zimward/datalogger/README.md

4-20mA dual channel Datalogger for long term averaging of in-field bus systems
