zimward/datalogger/hardware/Datenlogger.kicad_pcb

## KiCad design hardware/Datenlogger.kicad_pcb (2026-04-29)

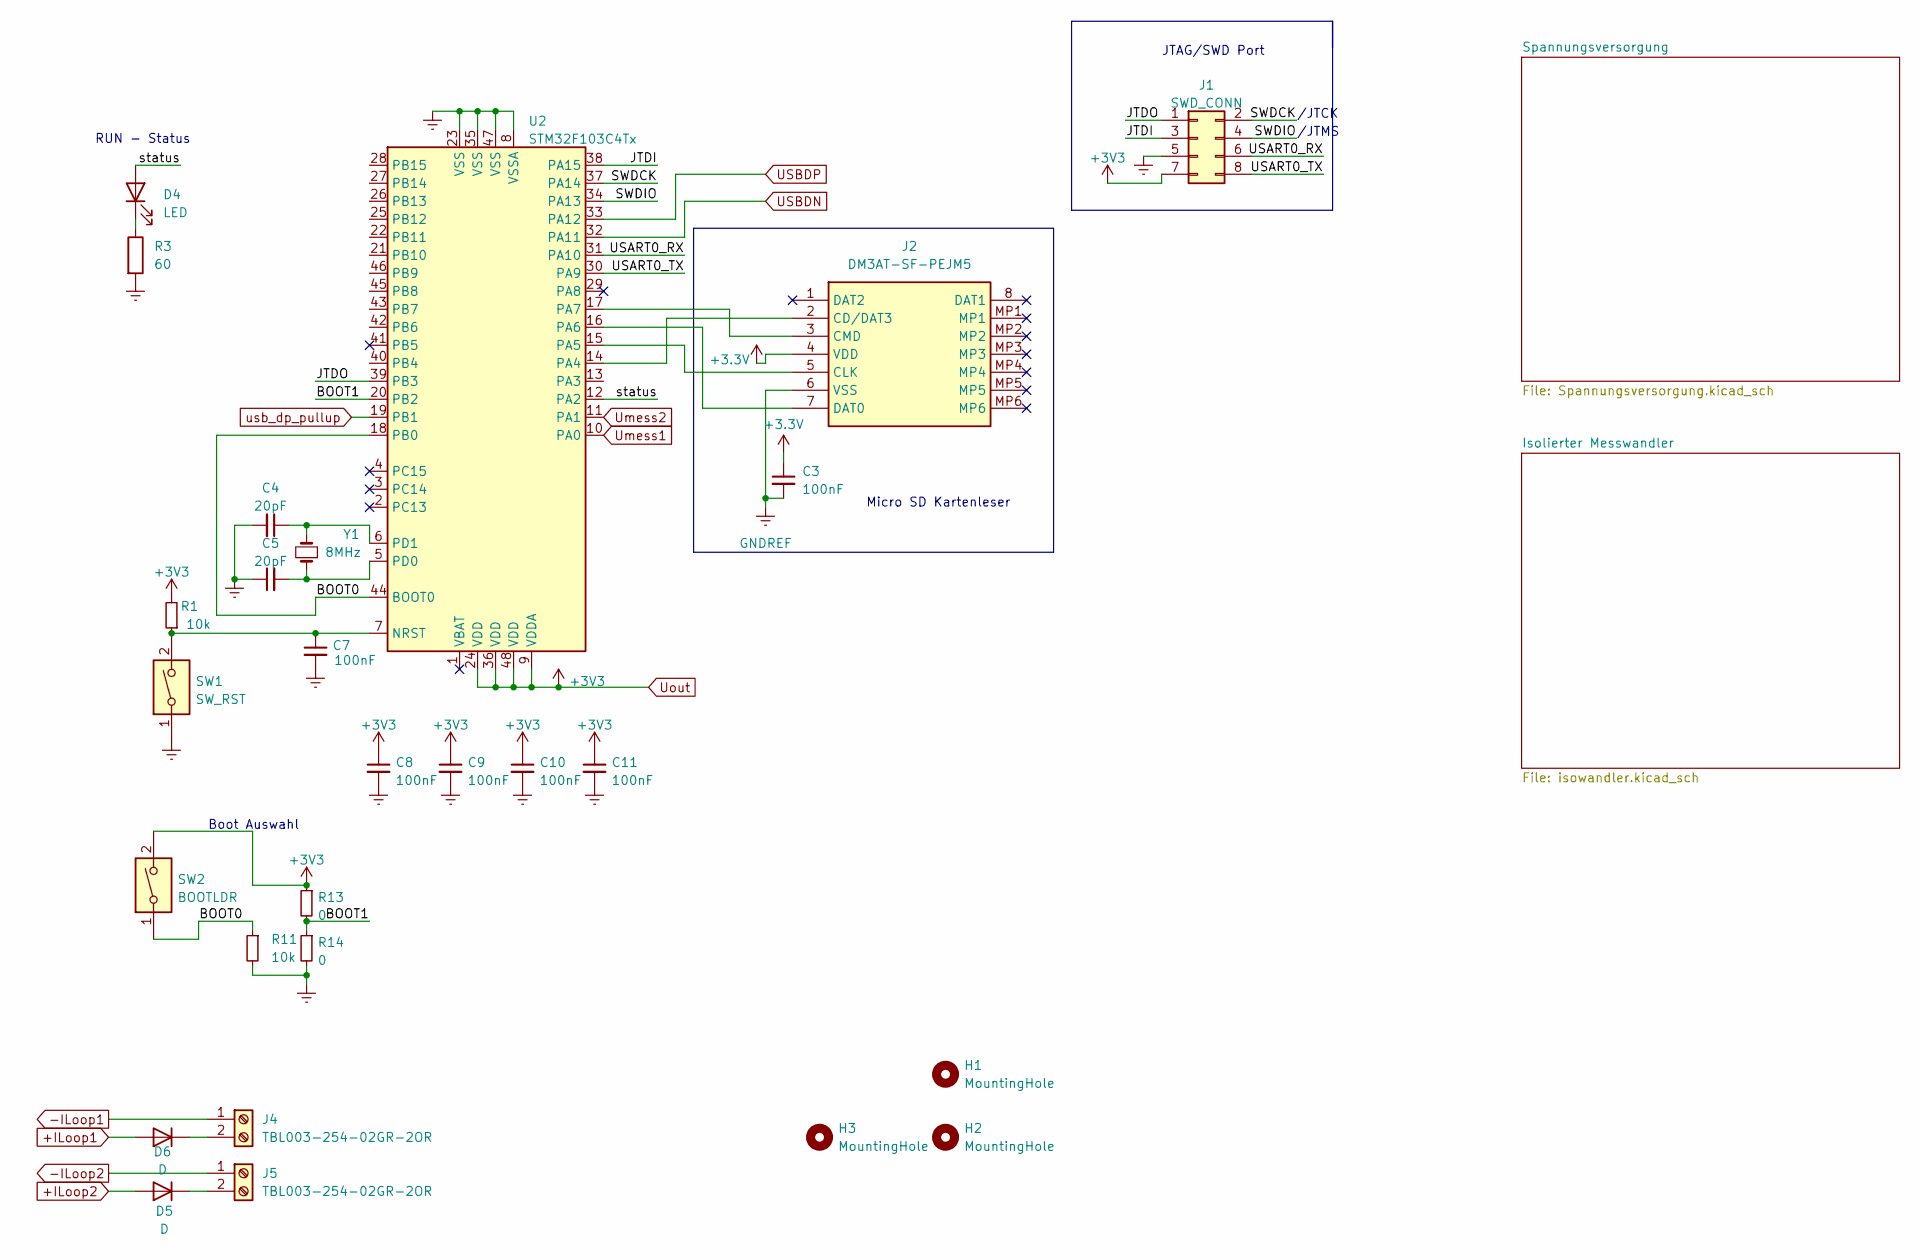
[picture p1: schematic Datenlogger.kicad_sch]

Parts:
C3, C7, C8, C9, C10, C11: 100nF; C_0805_2012Metric_Pad1.18x1.45mm_HandSolder
C4, C5: 20pF; C_0805_2012Metric_Pad1.18x1.45mm_HandSolder
D4: LED; LED_0805_2012Metric_Pad1.15x1.40mm_HandSolder
D5, D6: D; D_SOD-123
H1, H2, H3: MountingHole; MountingHole_3.2mm_M3_DIN965
J1: SWD_CONN; PinHeader_2x04_P2.54mm_Vertical
J2: DM3AT-SF-PEJM5; DM3ATSFPEJM5; Mouser Part Number 798-DM3AT-SF-PEJM5
J4, J5: TBL003-254-02GR-2OR; SHDR4W70P508X254_2X2_768X1380X1275P
R1, R11: 10k; R_0805_2012Metric_Pad1.20x1.40mm_HandSolder
R3: 60; R_0805_2012Metric_Pad1.20x1.40mm_HandSolder
R13, R14: 0; R_0805_2012Metric_Pad1.20x1.40mm_HandSolder
SW1: SW_RST; SW_DIP_SPSTx01_Slide_6.7x4.1mm_W7.62mm_P2.54mm_LowProfile
SW2: BOOTLDR; SW_DIP_SPSTx01_Slide_6.7x4.1mm_W7.62mm_P2.54mm_LowProfile
U2: STM32F103C4Tx; LQFP-48_7x7mm_P0.5mm
Y1: 8MHz; Crystal_SMD_HC49-SD

Connections:
+ILoop1: D6.2 (A); also elsewhere on the board
+ILoop2: D5.2 (A); also elsewhere on the board
-ILoop1: J4.1; also elsewhere on the board
-ILoop2: J5.1; also elsewhere on the board
/BOOT0: R11.1, SW2.1, U2.18 (PB0), U2.44 (BOOT0)
/BOOT1: R13.2, R14.1, U2.20 (PB2)
/JTDI: J1.3, U2.38 (PA15)
/JTDO: J1.1, U2.39 (PB3)
/SWDCK: J1.2, U2.37 (PA14)
/SWDIO: J1.4, U2.34 (PA13)
/USART0_RX: J1.6, U2.31 (PA10)
/USART0_TX: J1.8, U2.30 (PA9)
/status: D4.2 (A), U2.12 (PA2)
GNDREF: C3.2, C4.2, C5.1, C7.2, C8.2, C9.2, C10.2, C11.2, J1.5, J2.6 (VSS), R3.2, R11.2, R14.2, SW1.1, U2.8 (VSSA), U2.23 (VSS), U2.35 (VSS), U2.47 (VSS); also elsewhere on the board
unnamed: D4.1 (K), R3.1
unnamed: D5.1 (K), J5.2
unnamed: D6.1 (K), J4.2
unnamed: J2.2 (CD/DAT3), U2.14 (PA4)
unnamed: J2.5 (CLK), U2.15 (PA5)
unnamed: J2.3 (CMD), U2.17 (PA7)
unnamed: J2.7 (DAT0), U2.16 (PA6)
unnamed: C7.1, R1.1, SW1.2, U2.7 (NRST)
unnamed: C5.2, U2.5 (PD0), Y1.1
unnamed: C4.1, U2.6 (PD1), Y1.2
USBDN: U2.32 (PA11); also elsewhere on the board
USBDP: U2.33 (PA12); also elsewhere on the board
Umess1: U2.10 (PA0); also elsewhere on the board
Umess2: U2.11 (PA1); also elsewhere on the board
Uout: C3.1, C8.1, C9.1, C10.1, C11.1, J1.7, J2.4 (VDD), R1.2, R13.1, SW2.2, U2.9 (VDDA), U2.24 (VDD), U2.36 (VDD), U2.48 (VDD); also elsewhere on the board
usb_dp_pullup: U2.19 (PB1); also elsewhere on the board

Notes on the sheet:
JTAG/SWD Port
Micro SD Kartenleser
/JTMS
/JTCK
Boot Auswahl
RUN - Status

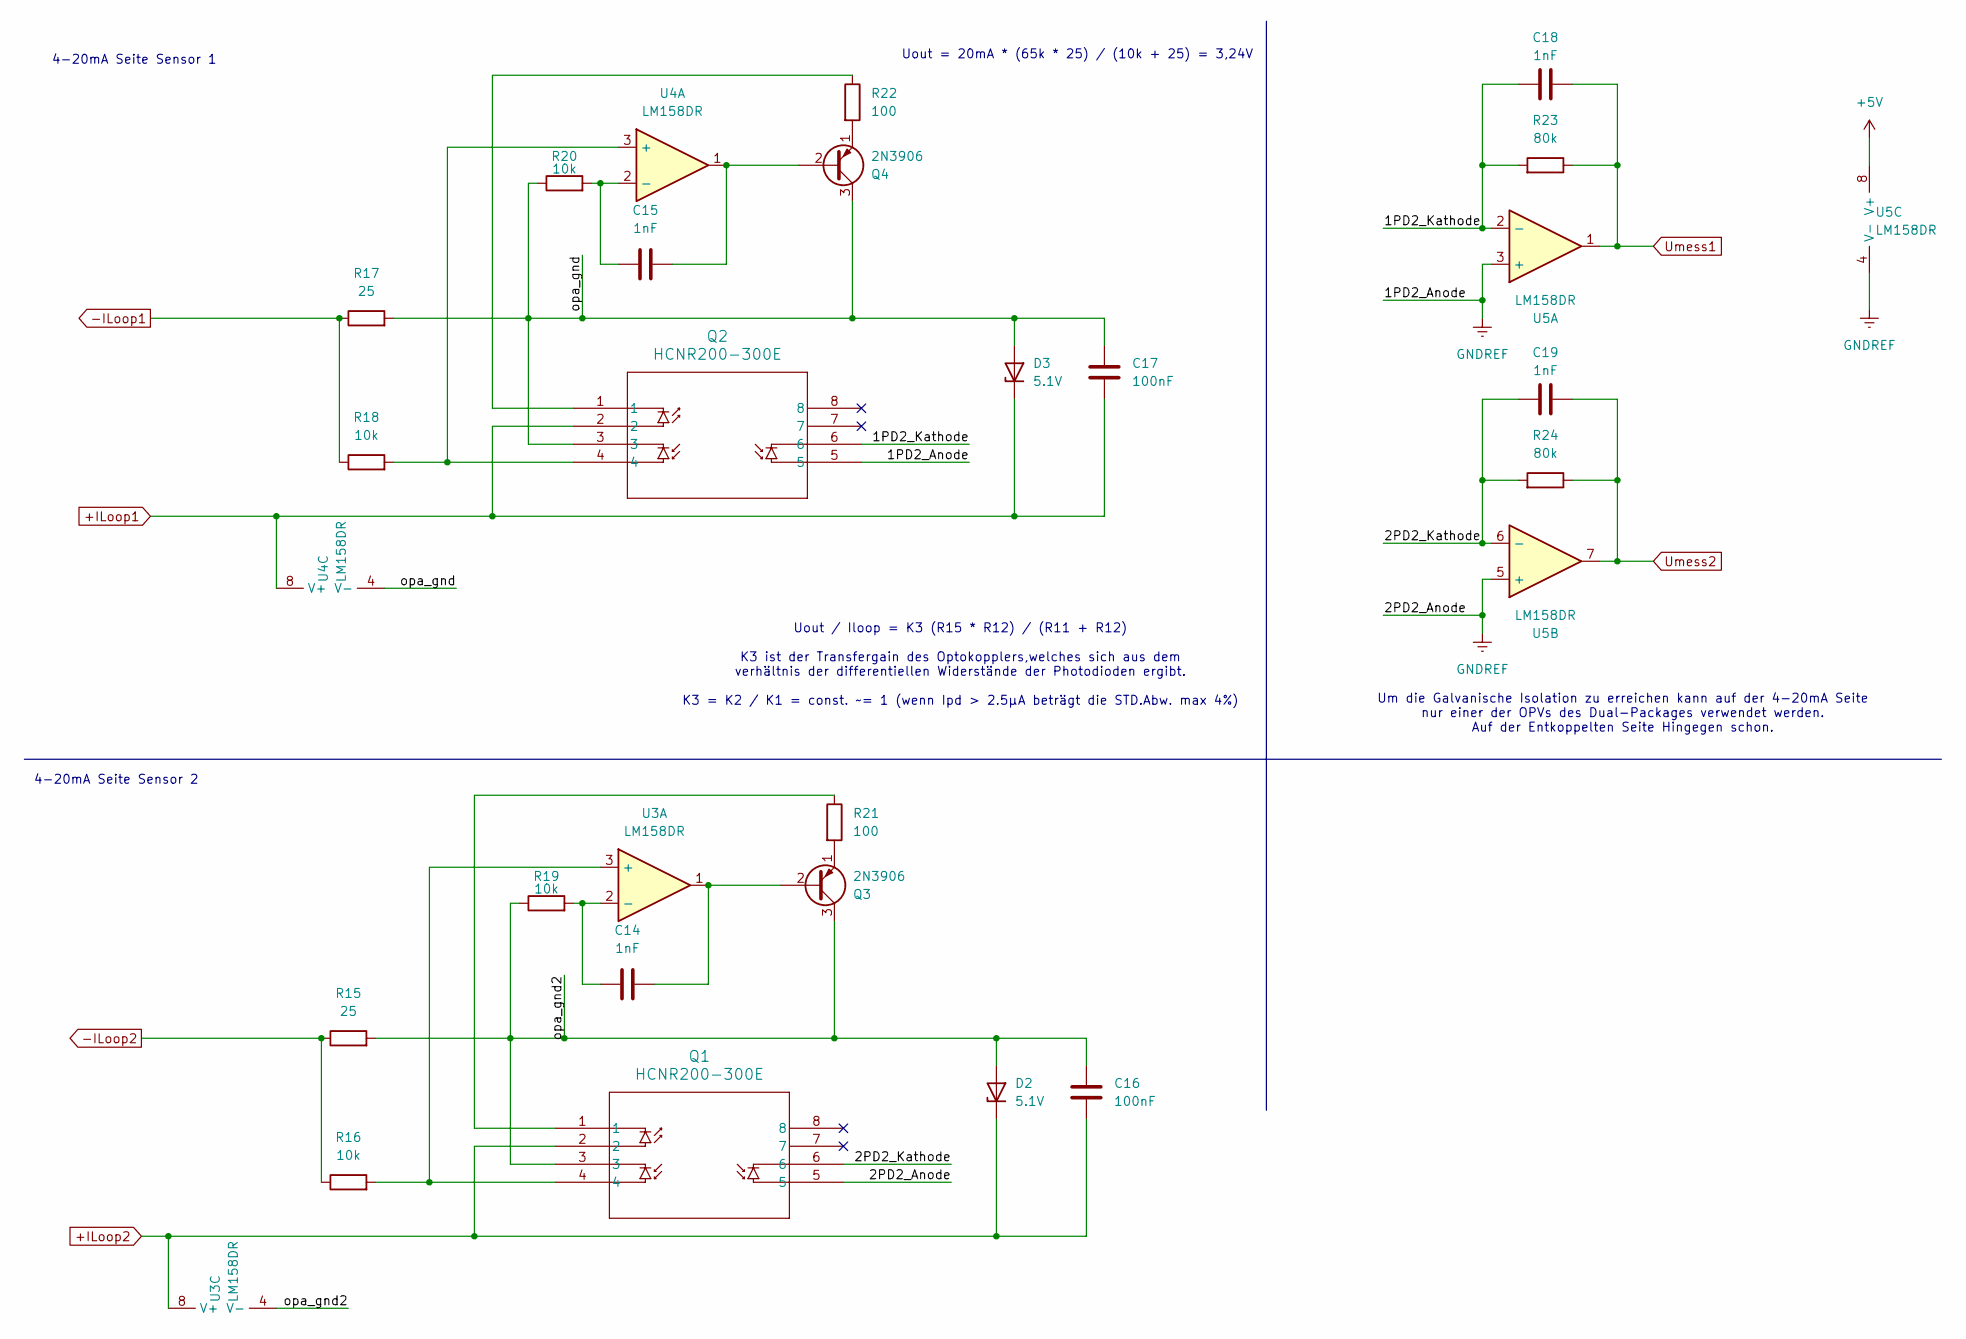
[picture p2: schematic isowandler.kicad_sch]

Parts:
C14, C15, C18, C19: 1nF; C_0805_2012Metric_Pad1.18x1.45mm_HandSolder
C16, C17: 100nF; C_0805_2012Metric_Pad1.18x1.45mm_HandSolder
D2, D3: 5.1V; D_SOD-123
Q1, Q2: HCNR200-300E
Q3, Q4: 2N3906; TO-92_Inline_Wide
R15, R17: 25; R_0805_2012Metric_Pad1.20x1.40mm_HandSolder
R16, R18, R19, R20: 10k; R_0805_2012Metric_Pad1.20x1.40mm_HandSolder
R21, R22: 100; R_0805_2012Metric_Pad1.20x1.40mm_HandSolder
R23, R24: 80k; R_0805_2012Metric_Pad1.20x1.40mm_HandSolder
U3, U4, U5: LM158DR; SOP-8_3.76x4.96mm_P1.27mm

Connections:
+5V: U5.8 (V+)
+ILoop1: C17.2, D3.1 (K), Q2.2, U4.8 (V+); also elsewhere on the board
+ILoop2: C16.2, D2.1 (K), Q1.2, U3.8 (V+); also elsewhere on the board
-ILoop1: R17.1, R18.1; also elsewhere on the board
-ILoop2: R15.1, R16.1; also elsewhere on the board
/Isolierter Messwandler/1PD2_Kathode: C18.1, Q2.6, R23.2, U5.2 (-)
/Isolierter Messwandler/2PD2_Kathode: C19.1, Q1.6, R24.2, U5.6 (-)
/Isolierter Messwandler/opa_gnd: C17.1, D3.2 (A), Q2.3, Q4.3 (C), R17.2, R20.1, U4.4 (V-)
/Isolierter Messwandler/opa_gnd2: C16.1, D2.2 (A), Q1.3, Q3.3 (C), R15.2, R19.1, U3.4 (V-)
GNDREF: Q1.5, Q2.5, U5.3 (+), U5.4 (V-), U5.5 (+); also elsewhere on the board
unnamed: Q1.1, R21.1
unnamed: Q2.1, R22.1
unnamed: C14.2, Q3.2 (B), U3.1
unnamed: Q3.1 (E), R21.2
unnamed: C15.2, Q4.2 (B), U4.1
unnamed: Q4.1 (E), R22.2
unnamed: Q1.4, R16.2, U3.3 (+)
unnamed: C14.1, R19.2, U3.2 (-)
unnamed: Q2.4, R18.2, U4.3 (+)
unnamed: C15.1, R20.2, U4.2 (-)
Umess1: C18.2, R23.1, U5.1; also elsewhere on the board
Umess2: C19.2, R24.1, U5.7; also elsewhere on the board

Notes on the sheet:
Um die Galvanische Isolation zu erreichen kann auf der 4-20mA Seite nur einer der OPVs des Dual-Packages verwendet werden. Auf der Entkoppelten Seite Hingegen schon.
Uout = 20mA * (65k * 25) / (10k + 25) = 3,24V
4-20mA Seite Sensor 1
Uout / Iloop = K3 (R15 * R12) / (R11 + R12) K3 ist der Transfergain des Optokopplers,welches sich aus dem verhältnis der differentiellen Widerstände der Photodioden ergibt. K3 = K2 / K1 = const. ~= 1 (wenn Ipd > 2.5µA beträgt die STD.Abw. max 4%)
4-20mA Seite Sensor 2

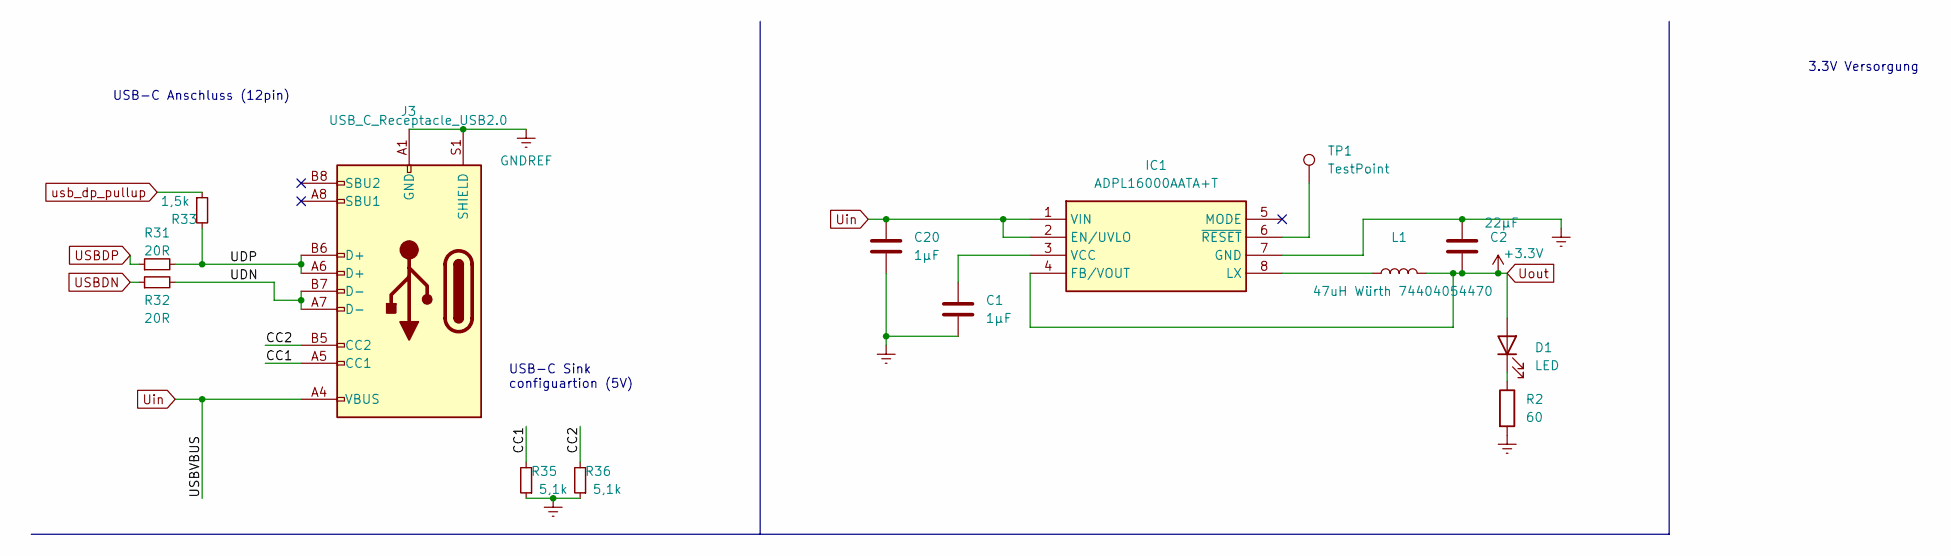
[picture p3: schematic Spannungsversorgung.kicad_sch]

Parts:
C1: 1µF; C_0805_2012Metric_Pad1.18x1.45mm_HandSolder
C2: 22µF; C_0805_2012Metric_Pad1.18x1.45mm_HandSolder
C20: 1µF; C_0805_2012Metric
D1: LED; LED_0805_2012Metric_Pad1.15x1.40mm_HandSolder
IC1: ADPL16000AATA+T; ADPL16000AATAT; Mouser Part Number 700-ADPL16000AATA+T
J3: USB_C_Receptacle_USB2.0; USB_C_Receptacle_Palconn_UTC16-G
L1: 47uH Würth 74404054470; 74404054470
R2: 60; R_0805_2012Metric_Pad1.20x1.40mm_HandSolder
R31, R32: 20R; R_0805_2012Metric_Pad1.20x1.40mm_HandSolder
R33: 1,5k; R_0805_2012Metric_Pad1.20x1.40mm_HandSolder
R35, R36: 5,1k; R_0805_2012Metric_Pad1.20x1.40mm_HandSolder
TP1: TestPoint; TestPoint_Pad_1.5x1.5mm

Connections:
/Spannungsversorgung/CC1: J3.A5 (CC1), R35.2
/Spannungsversorgung/CC2: J3.B5 (CC2), R36.2
/Spannungsversorgung/UDN: J3.A7 (D-), J3.B7 (D-), R32.2
/Spannungsversorgung/UDP: J3.A6 (D+), J3.B6 (D+), R31.2, R33.2
GNDREF: C1.2, C2.1, C20.2, IC1.7 (GND), J3.A1 (GND), J3.A12 (GND), J3.B1 (GND), J3.B12 (GND), J3.S1 (SHIELD), R2.2, R35.1, R36.1; also elsewhere on the board
unnamed: D1.1 (K), R2.1
unnamed: IC1.8 (LX), L1.1
unnamed: C1.1, IC1.3 (VCC)
unnamed: IC1.6 (~RESET), TP1.1
USBDN: R32.1; also elsewhere on the board
USBDP: R31.1; also elsewhere on the board
Uin: C20.1, IC1.1 (VIN), IC1.2 (EN/UVLO), J3.A4 (VBUS), J3.A9 (VBUS), J3.B4 (VBUS), J3.B9 (VBUS)
Uout: C2.2, D1.2 (A), IC1.4 (FB/VOUT), L1.2; also elsewhere on the board
usb_dp_pullup: R33.1; also elsewhere on the board

Notes on the sheet:
USB-C Sink configuartion (5V)
3.3V Versorgung
USB-C Anschluss (12pin)

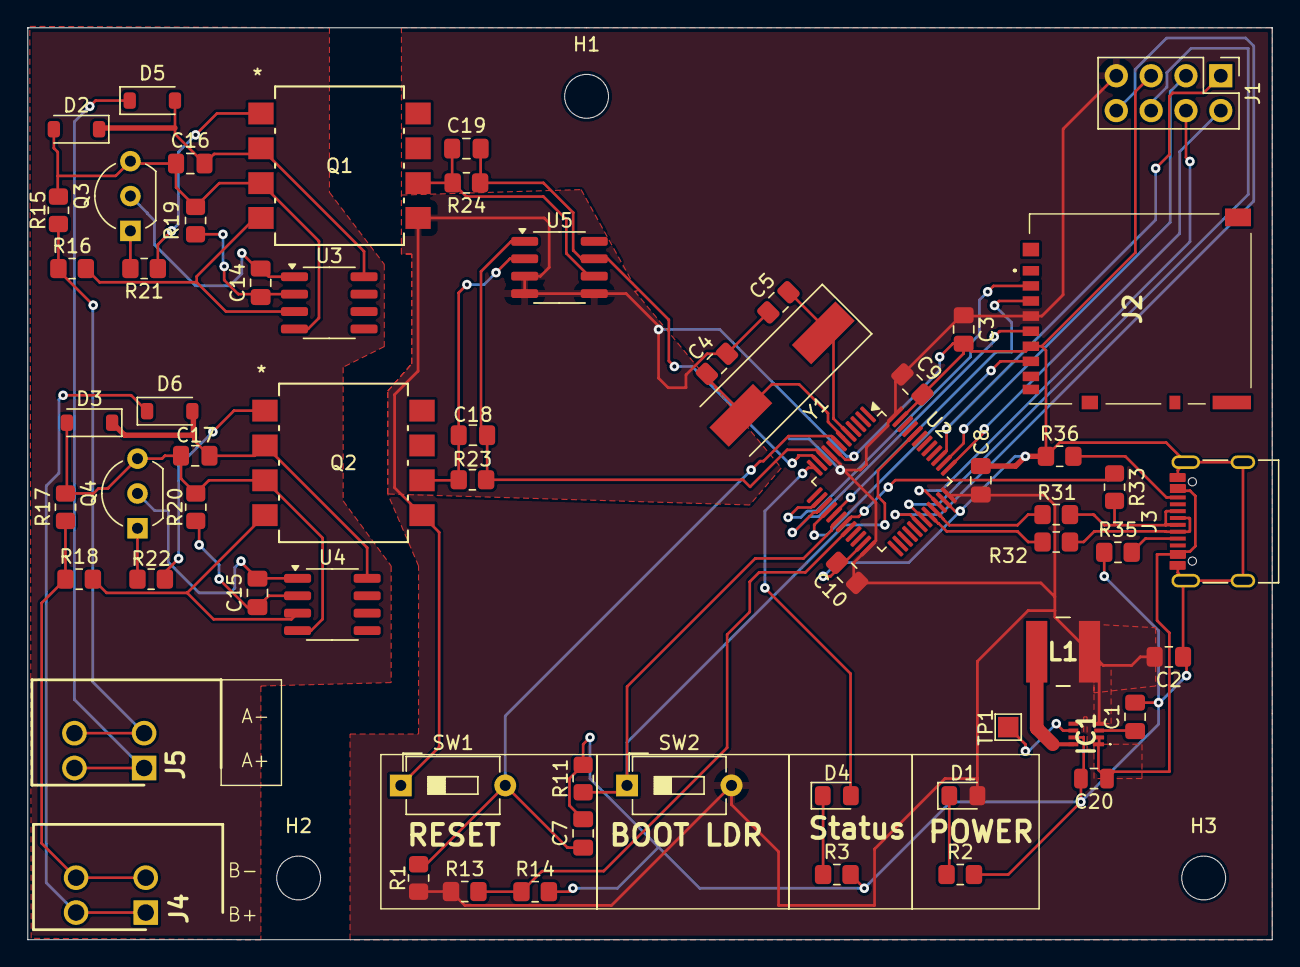
[picture p4: board Datenlogger.kicad_pcb from above]

Board: 2 copper layers, 90.8 x 66.5 mm, 66 parts (1 on the bottom side), 53 nets.
