zimward/datalogger/(commit log)

2025-03-12 add pin defs
2025-03-12 inital draft for led pwm control
2025-03-13 inital LED control; ADC with DMA
2025-03-17 implemented averaging of adc samples
2025-03-18 initial spi init
2025-04-11 emit different error code for malformed config
    [main.rs, sdcard.rs]
2025-04-14 fix sdcard pins, todo: adc processing
    [main.rs]
2025-04-22 increase SPI clock to 8MHz, as sdcard times out otherwise
2025-04-22 fix millis timer; implement start/stop logic
    [main.rs]
2026-04-29 add hardware design
    [Datenlogger.kicad_pcb, Datenlogger.kicad_sch, Spannungsversorgung.kicad_sch, isowandler.kicad_sch, noniso.kicad_sch, untitled.kicad_sch]
